Eng-Mohamed-Alaa/Mastering_Embedded_System_Diploma/README.md

# Mastering_Embedded_System_Diploma
### Mohamed Alaa
