Eng-Mohamed-Alaa/Mastering_Embedded_System_Diploma/Projects/Simple_Pressure_Detection/High_Presssure_Detection_Report.pdf

Mastering Embedded System Online Diploma

### https://www.learn-in-depth.com

## First Term (Final Project 1): High Pressure Detection

## Eng. Mohamed Alaa Al-Din Ibrahim Mohamed

My Profile: < learn-in-depth/online-diploma/mohamed.alaa.work.1@gmail.com> (https://www.learn-in-depth.com/online-diploma/mohamed.alaa.work.1%40gmail.com)

Project Link: <github/Mastering_Embedded_System_Diploma/first_term_project1> (https://github.com/Eng-Mohamed-Alaa/Mastering_Embedded_System_Diploma/tree/main/first_term_project1)

CONTENTS

6.5. Design simulation by TTool | Error! Bookmark not defined.

### 1. CASE STUDY

- Description:
- If the pressure exceeds 20 bars in the cabin the system detects high pressure
- When high pressure is detected, the system informs the crew with an alarm (LED)
- The alarm duration is 60 seconds
- In case of high pressure, the next value of pressure is measured after 20 seconds from the moment that alarm is off (quick check)
- In case of normal pressure, the next value of pressure is measured after 100 seconds (normal check)
- Assumptions:
- System setup, reset, and shutdown are not modeled
- The system maintenance is not modeled
- The controller power is never cut
- The pressure sensor never fails
- The alarm never fails

### 2. REQUIREMENT DIAGRAM

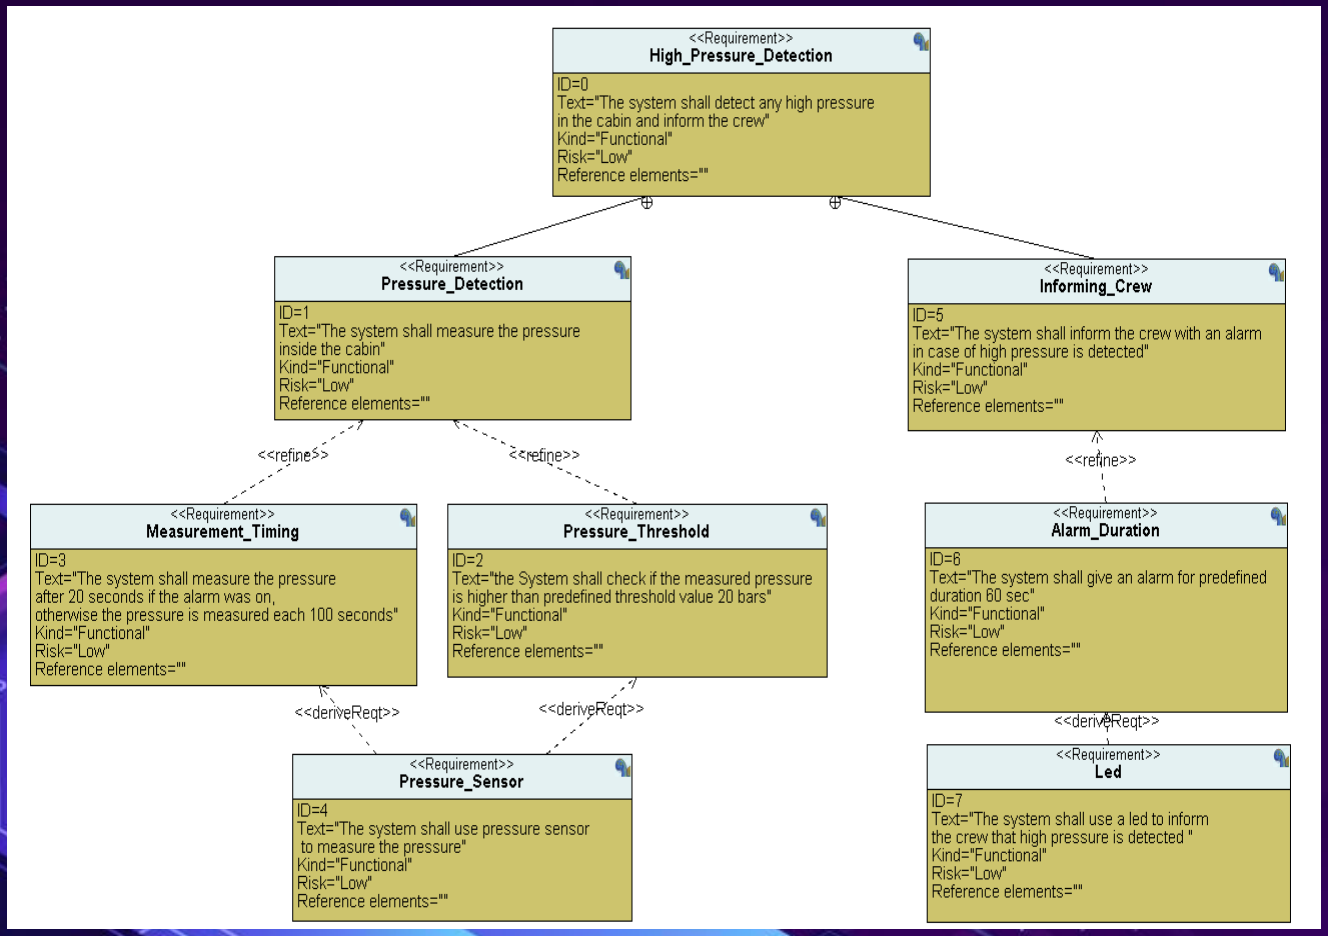
[picture p1: figure]

### 3. USE CASE DIAGRAM

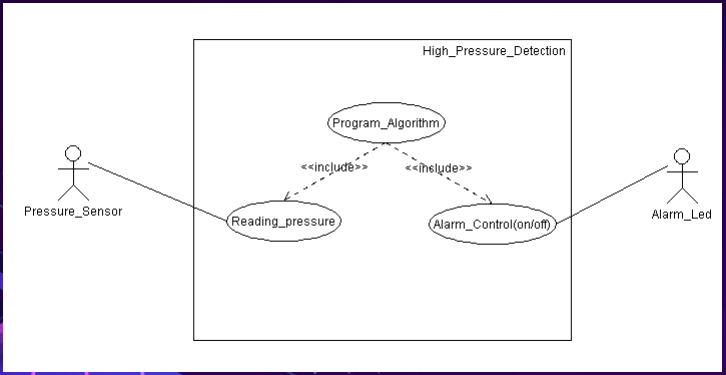
[picture p2: figure]

### 4. ACTIVITY DIAGRAM

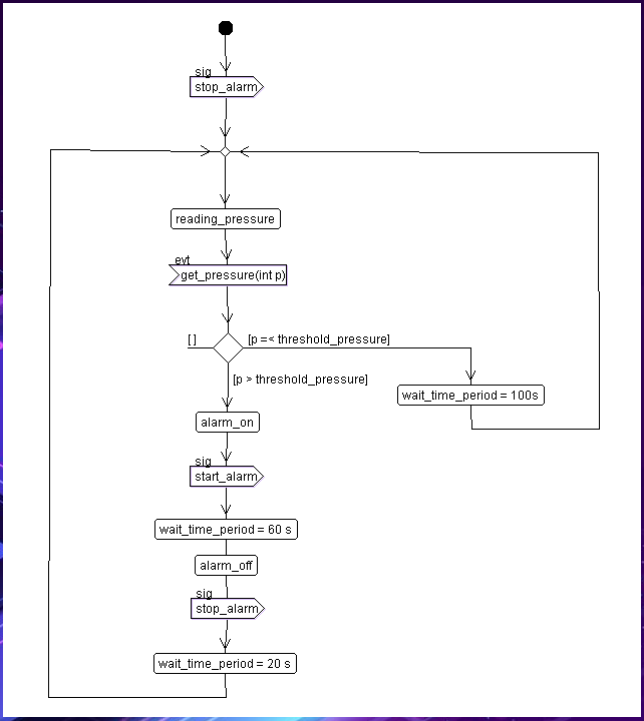
[picture p3: figure]

### 5. SEQUENCE DIAGRAM

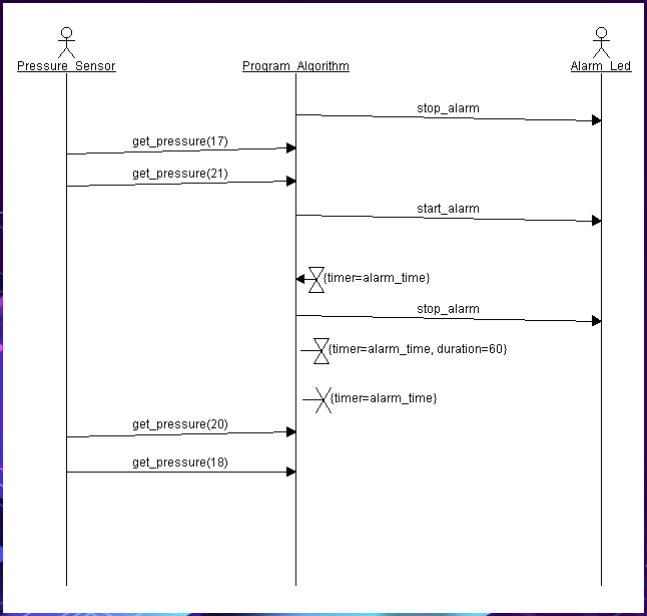
[picture p4: figure]

### 6. DESIGN DIAGRAM

### 6.1. Block diagram

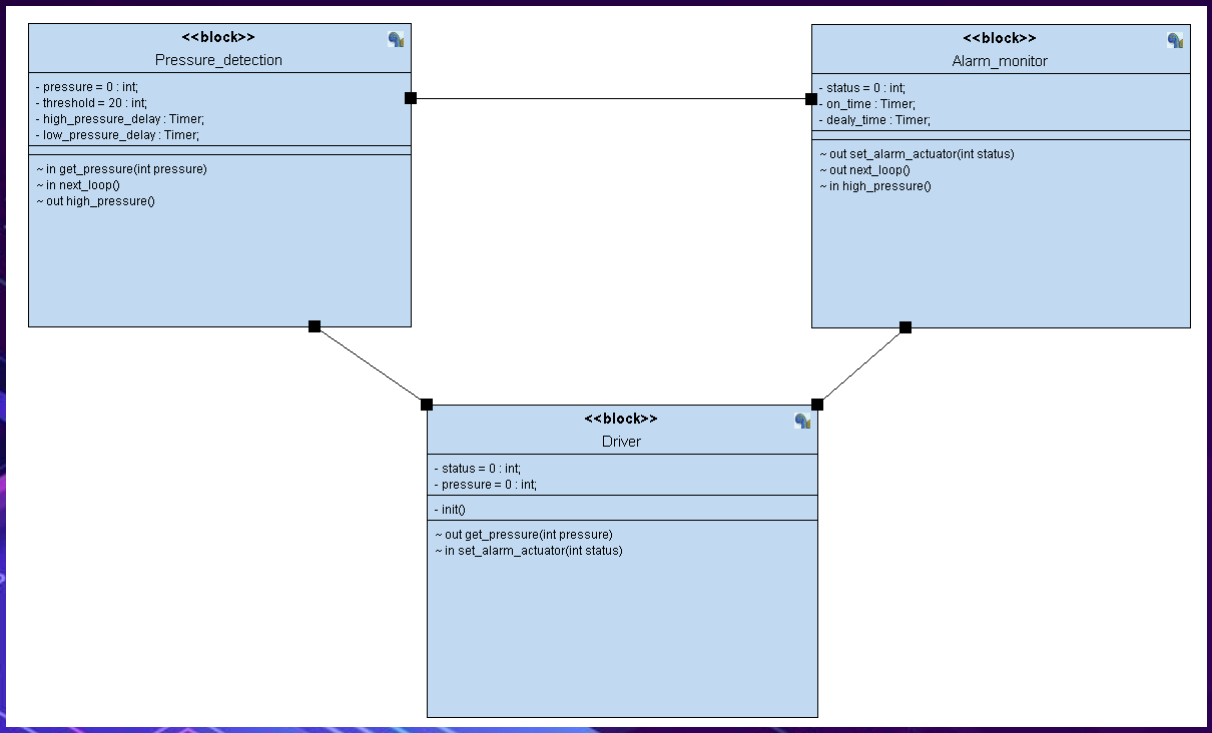
[picture p5: figure]

### 6.2. Pressure detection state machine diagram

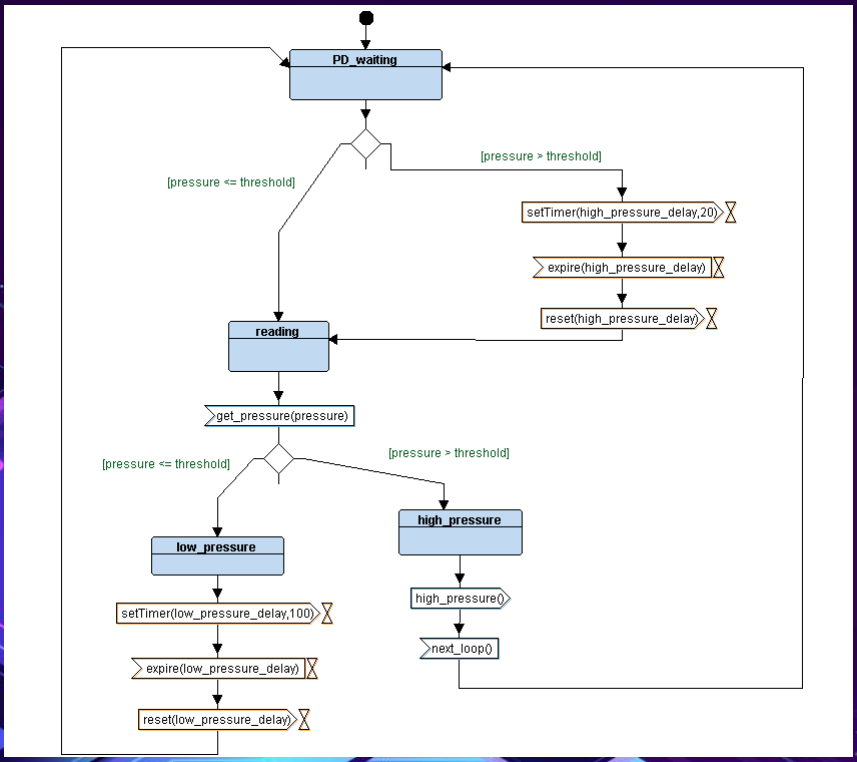
[picture p6: figure]

### 6.3. Alarm monitor state machine diagram

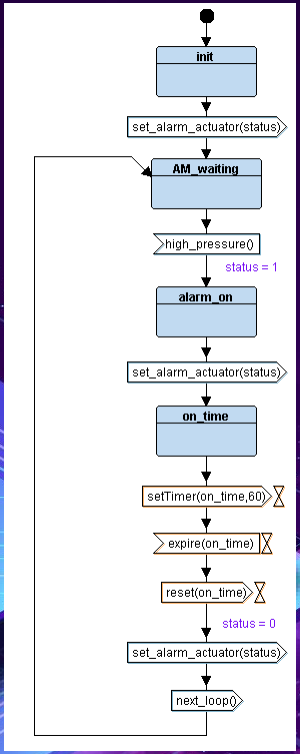
[picture p7: figure]

### 6.4. Driver state machine diagram

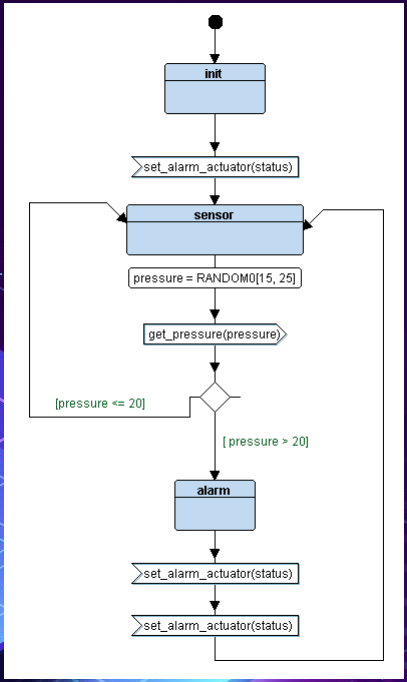
[picture p8: figure]

### 7. SYSTEM SIMULATION BY PROTEUS

### 7.1. Alarm on

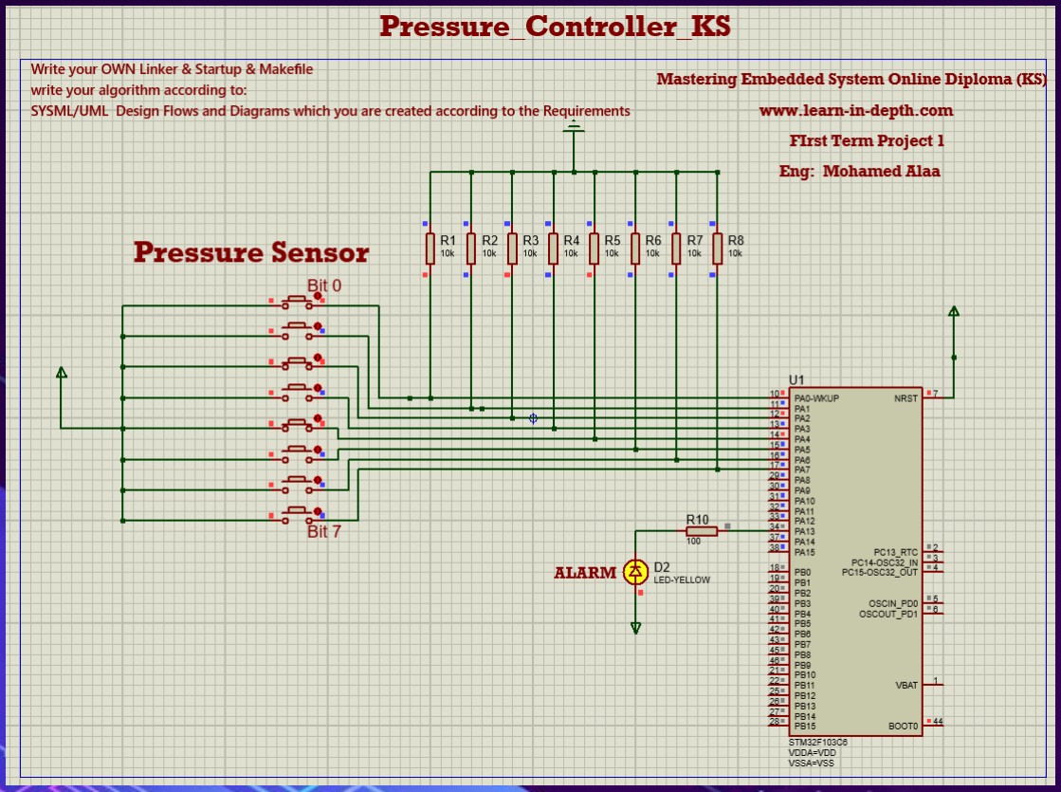
[picture p9: figure]

Pressure = 21 bar

### 7.2. Alarm off

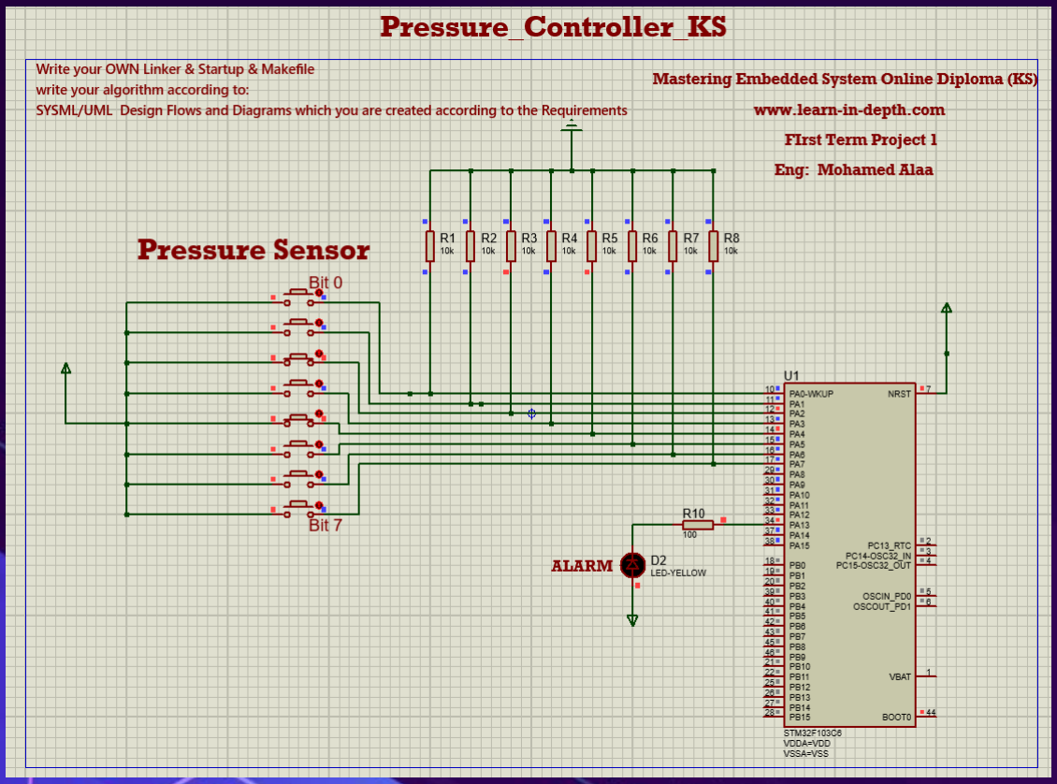
[picture p10: figure]

Pressure = 20 bar

### 8. SW ANALYSIS

### 8.1. Map file

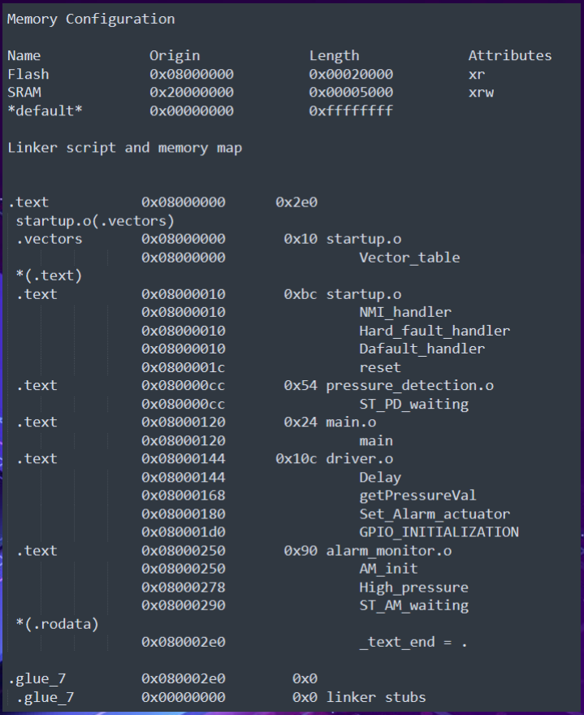
[picture p11: figure]

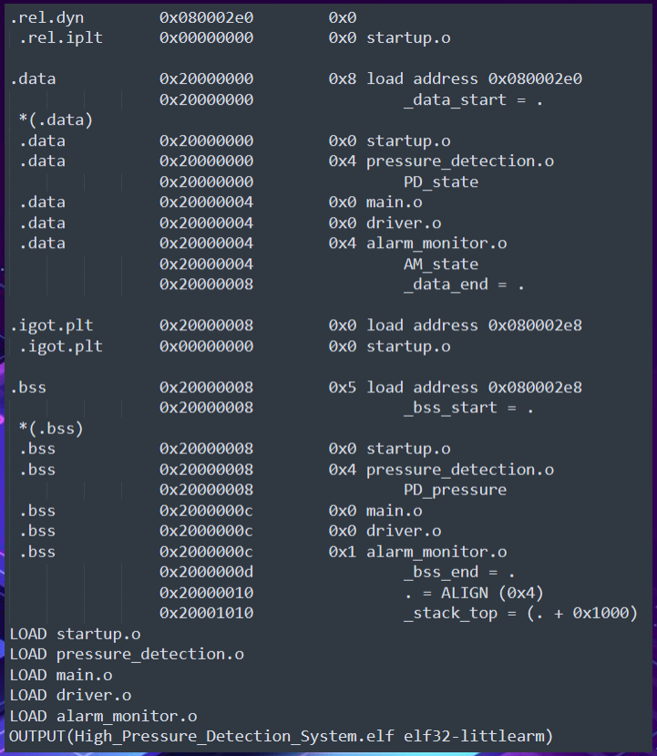
[picture p12: figure]

### 8.2. Section header

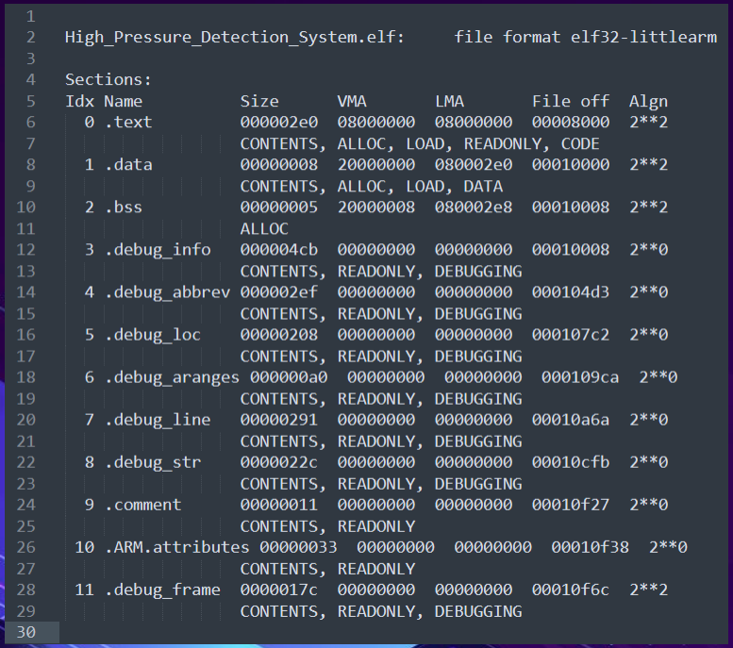
[picture p13: figure]

### 8.3. Symbol table

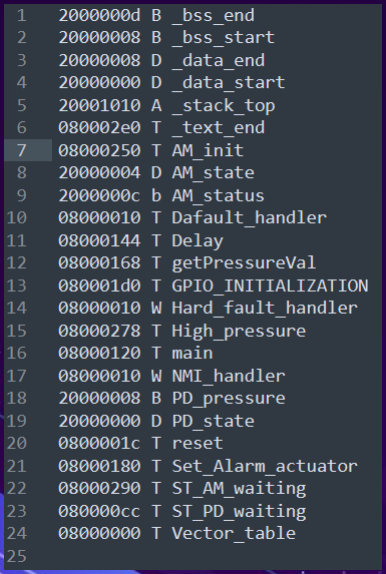
[picture p14: figure]
