Eng-Mohamed-Alaa/Mastering_Embedded_System_Diploma/Unit_4_ System_Architect/lesson_2/Report_Collision_Avoidance_Lab.pdf

# Mastering Embedded System Diploma

## Report name: Collision Avoidance Lab

(Unit 4, Lesson 2)

Submitted by: Eng. Mohamed Alaa

Content

1) Case study
2) Requirement diagram
3) Use case diagram
4) Activity diagram
5) Sequence diagram
6) Design diagram

6..1. Block diagram

6..2. Ultrasonic sensor state machine diagram

6..3. Collison avoidance state machine diagram

6..4. DC motor state machine diagram

7) Running the Program

1) Case study
1) Description:
- The car avoids collision, if the distance between the car and the object is greater than 50 cm the car moves with a constant speed of 30 km/h otherwise the car stops
- Distance is measured by the ultrasonic sensor
- Car moves with DC motor
2) Assumptions:
- System setup and shutdown is not modeled
- The system maintenance is not modeled
- The controller power is never cut
- The ultrasonic sensor never fails
- The DC motor never fails
- The distance is measured continuously without a time delay (time delay is code execution time)

2) Requirement diagram

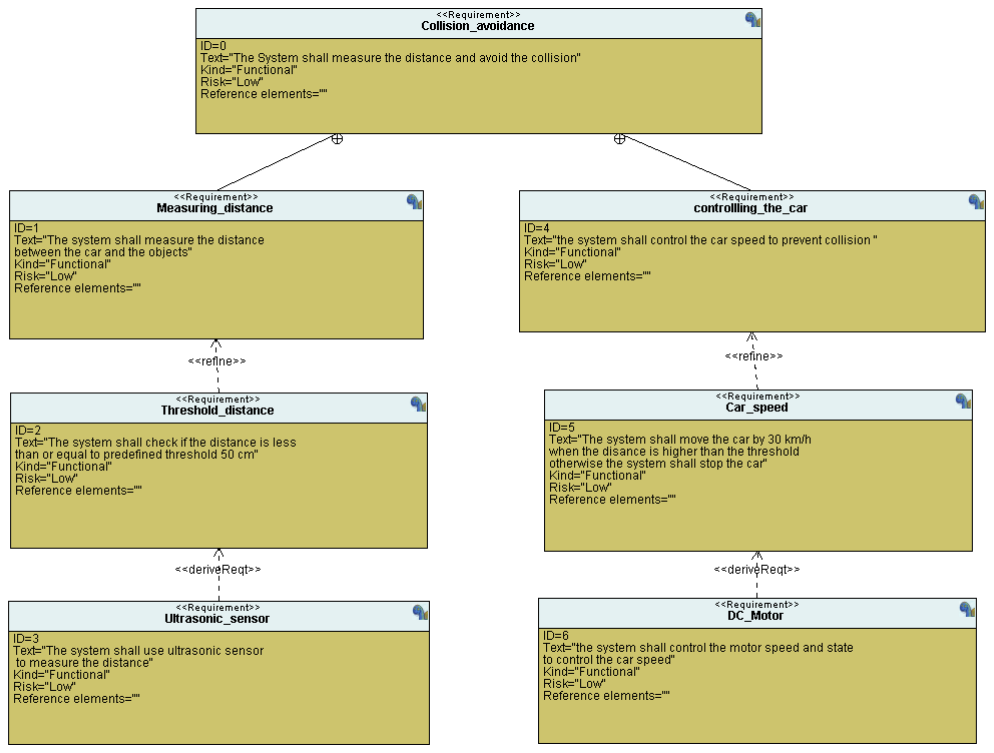
[picture p15: figure]

3) Use case diagram

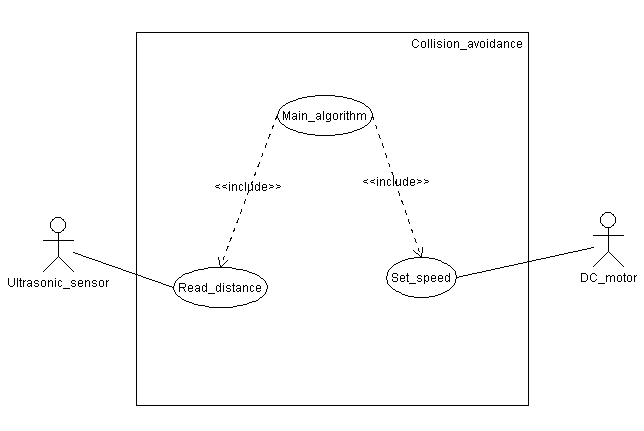
[picture p16: figure]

4) Activity diagram

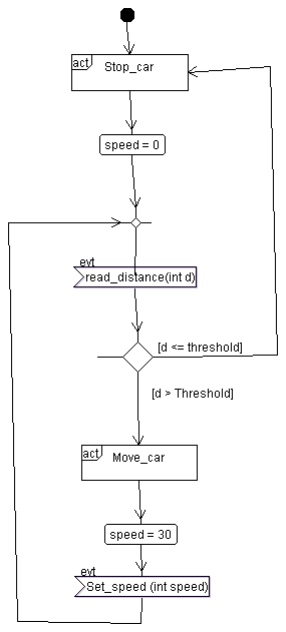
[picture p17: figure]

5) Sequence diagram

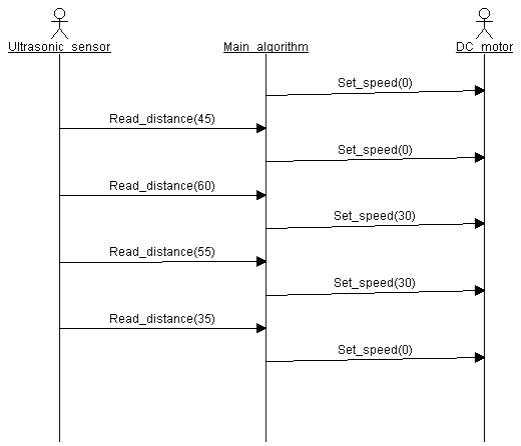
[picture p18: figure]

6) Design diagram

### 6.1. Block diagram

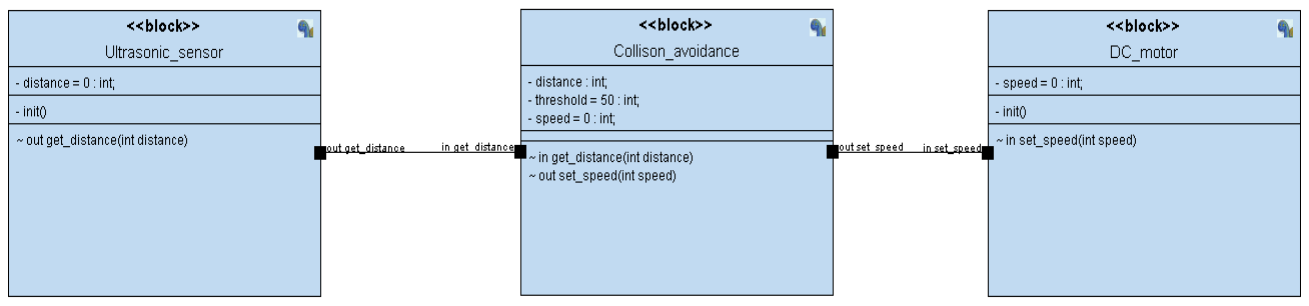
[picture p19: figure]

### 6.2. Ultrasonic sensor state machine diagram

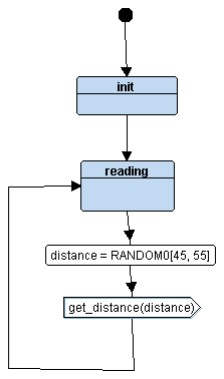
[picture p20: figure]

### 6.3. Collision avoidance state machine diagram

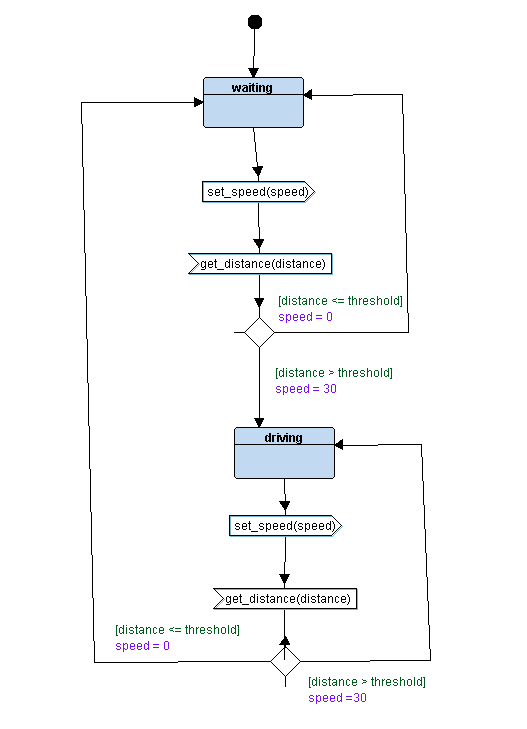
[picture p21: figure]

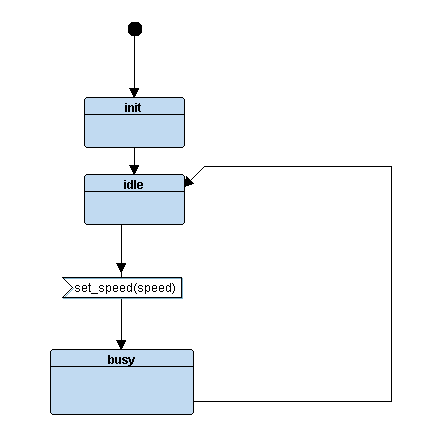
[picture p22: figure]

### 6.4. DC motor state machine diagram

7) Running the Program

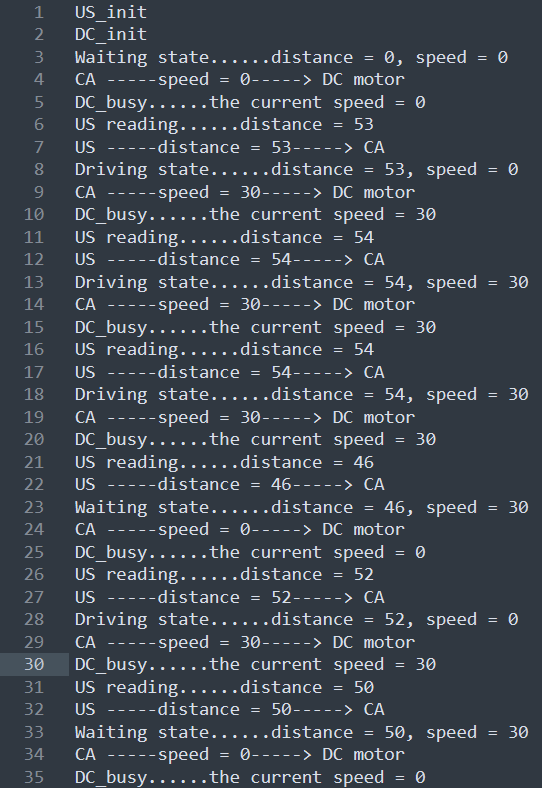
[picture p23: figure]
