Eng-Mohamed-Alaa/Mastering_Embedded_System_Diploma/Projects/Students_Management_System/Students_Management_System_Report.pdf

## Mastering Embedded System Online Diploma

### https://www.learn-in-depth.com

## First Term (Final Project 2)

## Eng. Mohamed Alaa Al-Din Ibrahim Mohamed

My Profile: <learn-in-depth.com/online-diploma/mohamed.alaa.work.1@gmail.com>

Project Link: <github/Mastering_Embedded_System_Diploma/first_term_project2> (https://github.com/Eng-Mohamed-Alaa/Mastering_Embedded_System_Diploma/tree/main/first_term_project2)

CONTENTS

OPTIONS MENU

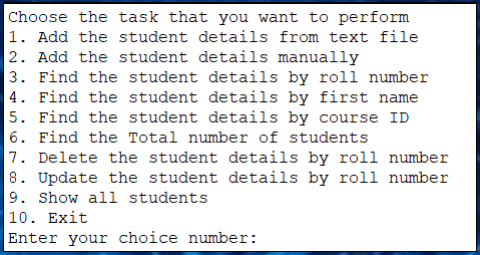
[picture p24: figure]

STUDENT_ADD_FILE()

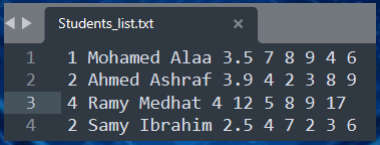
[picture p25: figure]
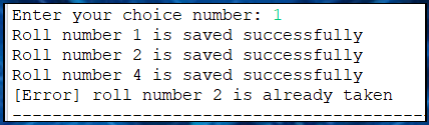
[picture p26: figure]
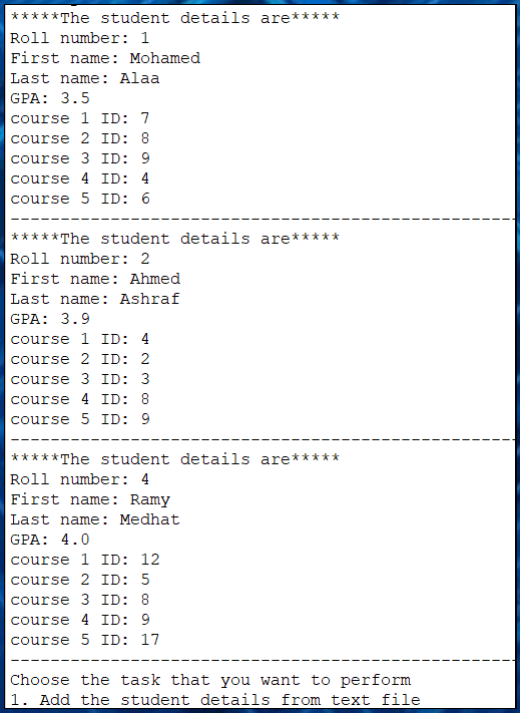
[picture p27: figure]
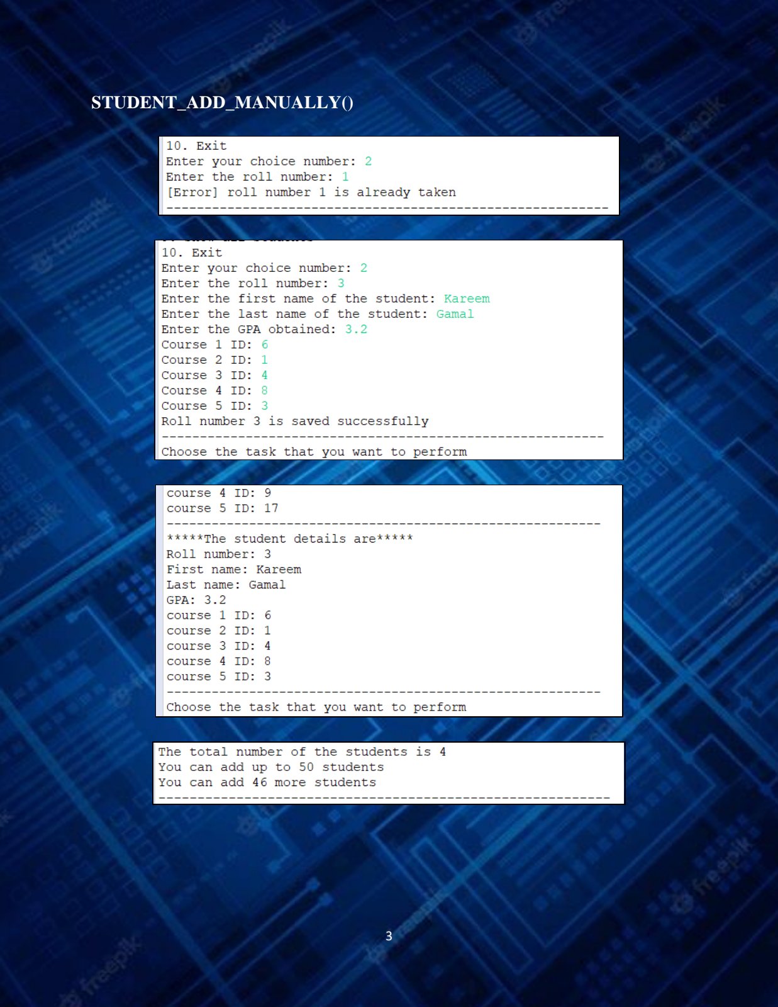
[picture p28: page 5]

STUDENT_ADD_MANUALLY()

STUDENT_FIND_BY_ROLL()

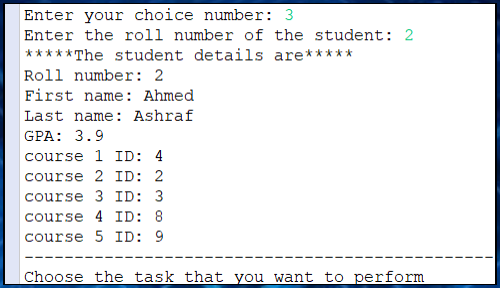
[picture p29: figure]

STUDENT_FIND_BY_FN()

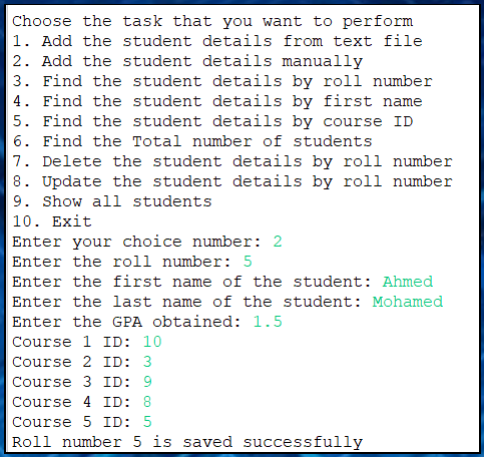
[picture p30: figure]
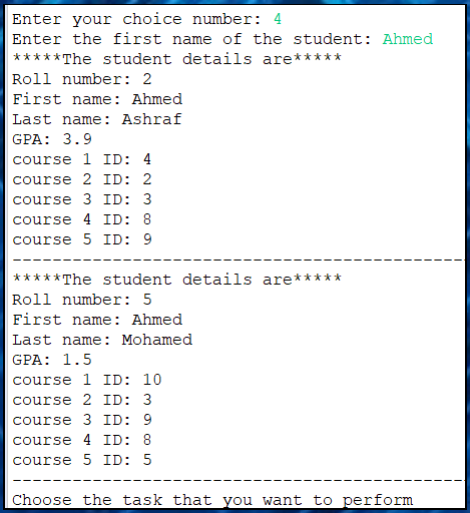
[picture p31: figure]

STUDENT_FIND_BY_COURSE()

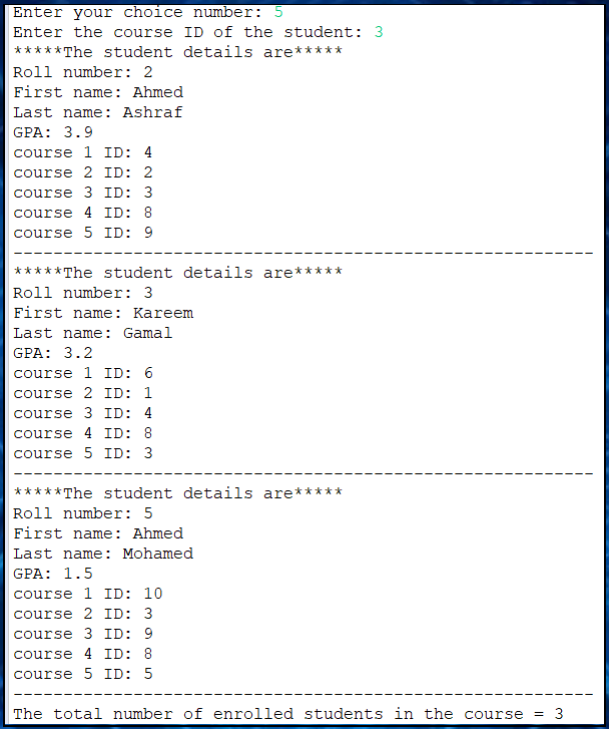
[picture p32: figure]

STUDENT_TOTAL()

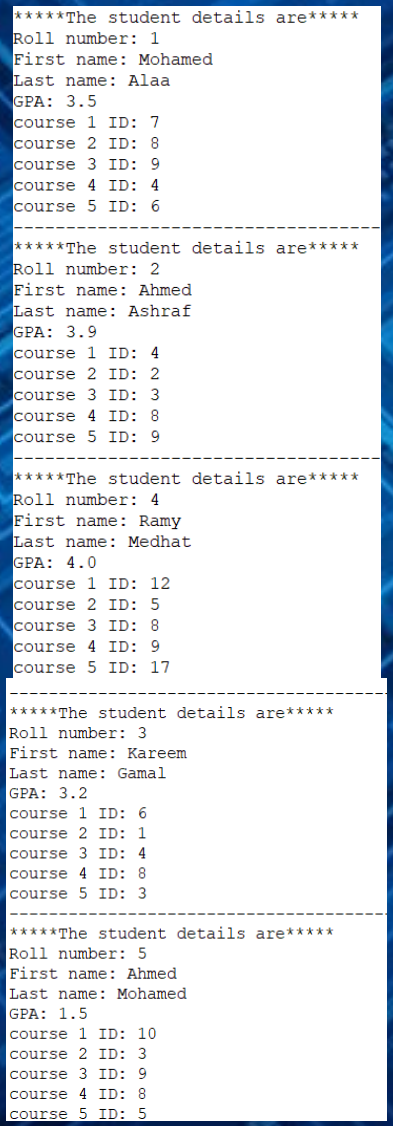
[picture p33: figure]

STUDENT_DELETE()

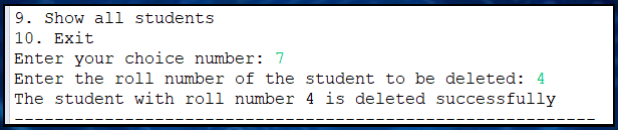
[picture p34: figure]
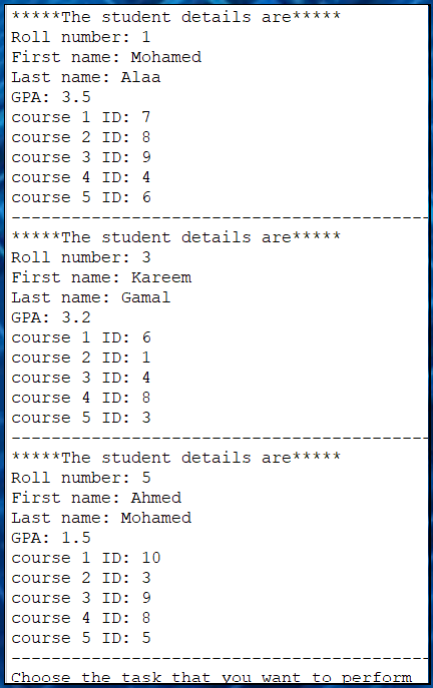
[picture p35: figure]

STUDENT_UPDATE()

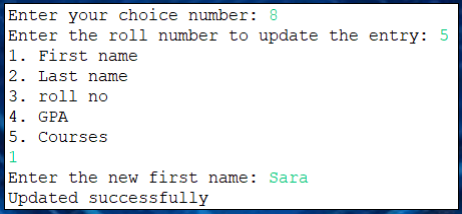
[picture p36: figure]
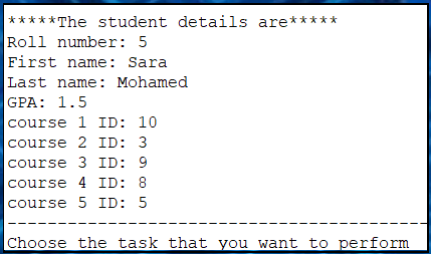
[picture p37: figure]

STUDENT_SHOW_ALL()

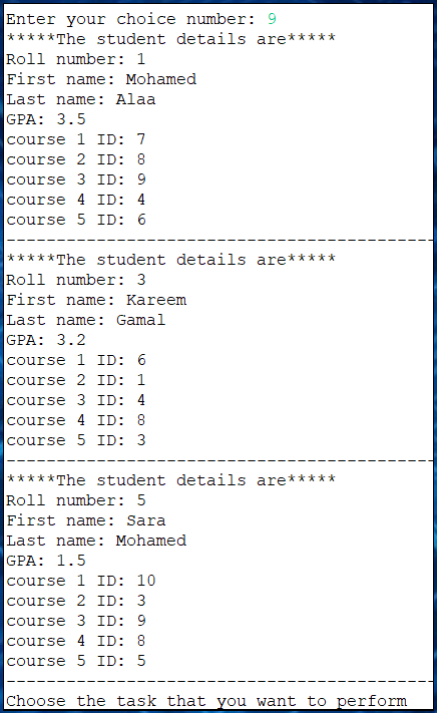
[picture p38: figure]
