Eng-Mohamed-Alaa/Mastering_Embedded_System_Diploma/Projects/Automotive_Diagnostic_Tool_OBD/Diagnostic Tool_State_Machine.png

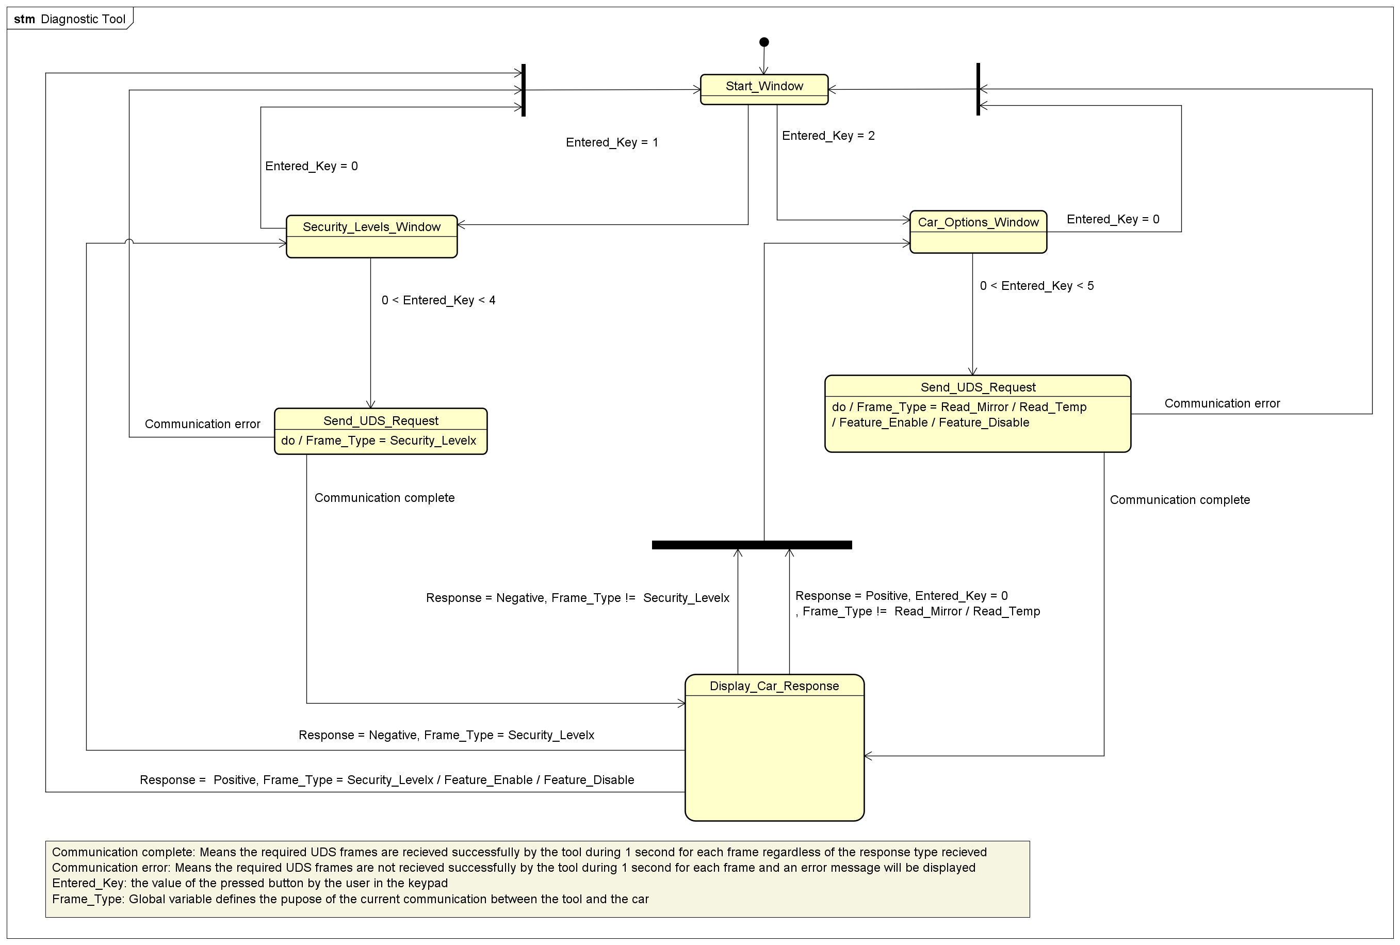
Projects/Automotive_Diagnostic_Tool_OBD/Diagnostic Tool_State_Machine.png
