Eng-Mohamed-Alaa/Mastering_Embedded_System_Diploma/Projects/Automotive_Diagnostic_Tool_OBD/Diagnostic_Tool_Activity_Diagram.png

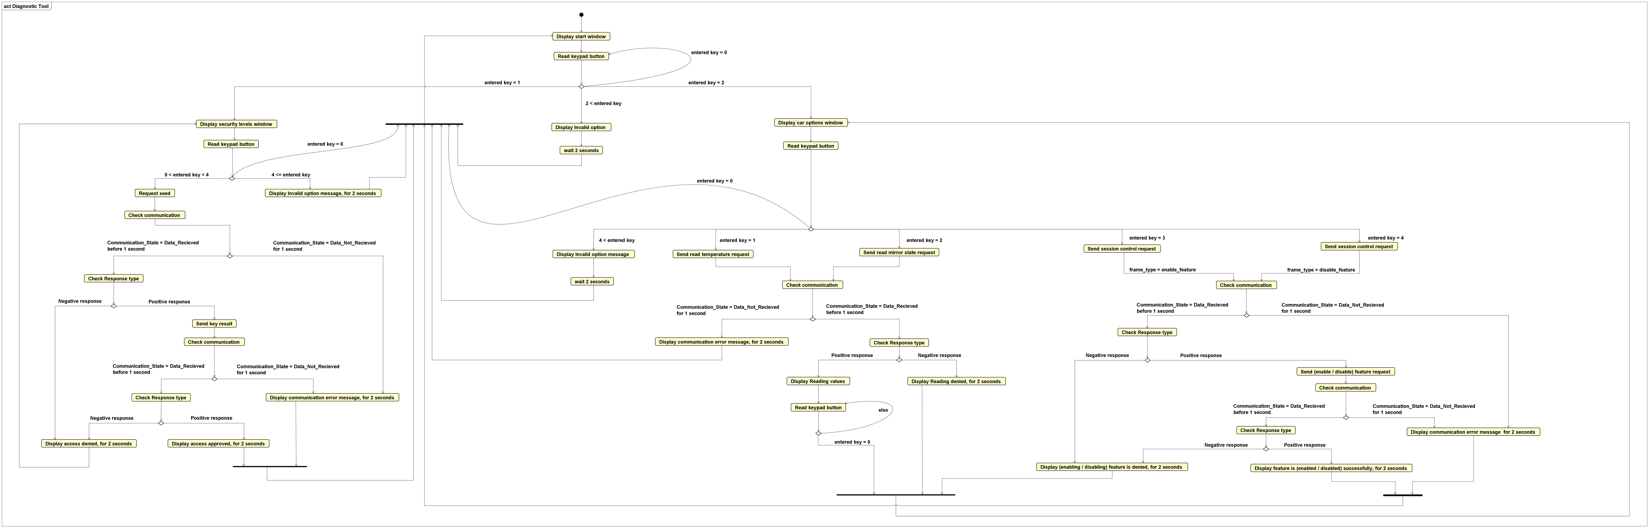
Projects/Automotive_Diagnostic_Tool_OBD/Diagnostic_Tool_Activity_Diagram.png
