Eng-Mohamed-Alaa/Mastering_Embedded_System_Diploma/(list of files, drawings)

Other design files:
Projects/Automotive_Diagnostic_Tool_OBD/Car_ECU/Simulation_Proteus/New Project.pdsprj
Projects/Simple_Pressure_Detection/Hardware_Simulation/yarb.pdsprj
Projects/Smart_Home_FreeRTOS/Simulation/FreeRTOS_Smart_Home.pdsprj
Unit_6_MCU_fundamentals/Lesson_4/Assignment/simulation/New Project.pdsprj
Unit_7_essential_peripherals/lesson_1/Assignment/hardware/AMITKIT.pdsprj
Unit_7_essential_peripherals/lesson_1/Lab/HW/unit7_lesson1.pdsprj
Unit_7_essential_peripherals/lesson_2/Assignment/hardware/LCD_Keypad_ATMEGA32.pdsprj
Unit_7_essential_peripherals/lesson_3/Assignment/HW/unit7_lesson1.pdsprj
Unit_7_essential_peripherals/lesson_3/Lab/HW/unit7_lesson1.pdsprj
Unit_7_essential_peripherals/lesson_4/Lab/HW/unit7_lesson1.pdsprj
Unit_8_MCU_Communication_Protocols/lesson2_UART/Assignment/Assignment_Simulation/LCD_Keypad_ATMEGA32.pdsprj
Unit_8_MCU_Communication_Protocols/lesson3_UART/Assignment/Simulation/LCD_Keypad_ATMEGA32.pdsprj
Unit_8_MCU_Communication_Protocols/lesson3_UART/Lab/Simulation/unit8_lesson3_uart.pdsprj
Unit_8_MCU_Communication_Protocols/lesson4_SPI/Assignment_SPI_7segment/Simulation/New Project.pdsprj
Unit_8_MCU_Communication_Protocols/lesson4_SPI/Assignment_SPI_Master_Slave/Simulation/SPI between two Atmega.pdsprj
Unit_8_MCU_Communication_Protocols/Lesson5_SPI/Lab/Simulation/unit8_lesson5_SPI_lab1.pdsprj
Unit_8_MCU_Communication_Protocols/Lesson5_SPI/Lab/Simulation/unit8_lesson5_SPI_lab2.pdsprj
Unit_8_MCU_Communication_Protocols/Lesson6_I2C/Asignment_HW/SPI between two Atmega.pdsprj
Unit_9_MCU_Timers_ADC/lesson1_Timers/Asignment_Simulation/Timers.pdsprj
Unit_9_MCU_Timers_ADC/lesson2_ADC/Asignment_Simulation/ADC.pdsprj
