Eng-Mohamed-Alaa/Mastering_Embedded_System_Diploma/Unit_6_MCU_fundamentals/Lesson_3/software/Src/lab3.c

//By: Eng.Mohamed Alaa (STM32CubeIDE)
//You can only build 1 lab.c at a time in this project
//from resources configuration you can choose the lab to build

#define RCC_Base	 0x40021000
#define GPIOA_Base	 0x40010800
typedef volatile unsigned long  vuint32_t;


#define RCC_CFGR 	*(vuint32_t *) (RCC_Base + 0x04 )
#define RCC_CR	 	*(vuint32_t *) (RCC_Base)
#define RCC_APB2ENR *(vuint32_t *) (RCC_Base + 0x18 )
#define GPIOA_CRH 	*(vuint32_t *) (GPIOA_Base+0x04)
#define GPIOA_ODR 	*(vuint32_t *) (GPIOA_Base+0x0c)

int main(void)
{
	/*Bits 21:18 PLLMUL[3:0]: PLL multiplication factor
	These bits are written by software to define the PLL multiplication factor. They can be written only
	when PLL is disabled.
	0110: PLL input clock x 8*/
	//PLL source is by default equal to HSI/2 (4 MHz)
	RCC_CFGR |= (0b0110)<<18;

	/*Bit 24 PLLON: PLL enable
	Set and cleared by software to enable PLL.
	Cleared by hardware when entering Stop or Standby mode. This bit can not be reset if the
	PLL clock is used as system clock or is selected to become the system clock. Software
	must disable the USB OTG FS clock before clearing this bit.
	0: PLL OFF
	1: PLL ON*/
	RCC_CR |= 1<<24;

	/*Bits 1:0 SW[1:0]: System clock Switch
	Set and cleared by software to select SYSCLK source.
	Set by hardware to force HSI selection when leaving Stop and Standby mode or in case of failure of
	the HSE oscillator used directly or indirectly as system clock (if the Clock Security System is
	enabled).
	00: HSI selected as system clock
	01: HSE selected as system clock
	10: PLL selected as system clock
	11: Not allowed*/
	RCC_CFGR |= 1<<1;

	/*Bits 10:8 PPRE1[2:0]: APB Low-speed prescaler (APB1)
	Set and cleared by software to control the division factor of the APB Low speed clock (PCLK1).
	100: HCLK divided by 2*/
	RCC_CFGR |= (0b100) << 8;

	/*Bits 13:11 PPRE2[2:0]: APB high-speed prescaler (APB2)
	Set and cleared by software to control the division factor of the APB High speed clock (PCLK2).
	101: HCLK divided by 4*/
	RCC_CFGR |= (0b101) << 11;

	/*Bit 2 IOPAEN: I/O port A clock enable
	Set and cleared by software.
	0: I/O port A clock disabled
	1:I/O port A clock enabled*/
	RCC_APB2ENR |= 1<<2;
	GPIOA_CRH &= 0xff0fffff;
	GPIOA_CRH |= 0x00200000;
	while(1)
	{
		GPIOA_ODR |= 1<<13;
		for(int i=0; i < 5000; ++i){}
		GPIOA_ODR &= ~(1<<13);
		for(int i=0; i < 5000; ++i){}
	}
	return 0;
}
