Eng-Mohamed-Alaa/Mastering_Embedded_System_Diploma/Projects/Smart_Home_FreeRTOS/Code/AVR_ATmega32_Drivers/HAL/LM35_Sensor/LM35_Includes/lm35_Cfg.h

#ifndef LM35_CFG_H
#define LM35_CFG_H

#include <MCAL/PORT/PORT_Includes/Port.h>
#include <MCAL/ADC/ADC_Includes/ADC.h>

#define SENSOR_CHANNEL			  ADC_Channel_ADC0
#define SENSOR_MAX_VOLT_VALUE     1.5
#define SENSOR_MAX_TEMPERATURE    150
#define ADC_REF_VOLT_VALUE		  5
#define ADC_MAXIMUM_VALUE		  1023


#endif
