Eng-Mohamed-Alaa/Mastering_Embedded_System_Diploma/Projects/Smart_Home_FreeRTOS/Code/AVR_ATmega32_Drivers/MCAL/PORT/PORT_Includes/Port_Private.h

/*
 * Port_Private.h
 *
 * Created: 10/20/2023 12:11:10 PM
 *  Author: computer store
 */ 

#ifndef PORT_PRIVATE_H_
#define PORT_PRIVATE_H_

// this file is empty but may be used for the future features



#endif /* PORT_PRIVATE_H_ */
