Eng-Mohamed-Alaa/Mastering_Embedded_System_Diploma/Unit_8_MCU_Communication_Protocols/lesson7_I2C/Lab_SW/HAL/Inc/I2C_Slave_EEPROM.h

#ifndef INC_I2C_SLAVE_EEPROM_H_
#define INC_I2C_SLAVE_EEPROM_H_

//--------------------------------------------------------
//includes
//--------------------------------------------------------

#include <stdint.h>
#include <STM32F103C6_I2C_Driver.h>

//--------------------------------------------------------
//configuration macros
//--------------------------------------------------------

#define EEPROM_Slave_Address	0x2A

//--------------------------------------------------------
//EEPROM APIs
//--------------------------------------------------------

void EEPROM_Init(void);
uint8_t	EEPROM_Write_Nbytes(uint16_t Memory_Address, uint8_t* Data, uint8_t Data_Length);
uint8_t	EEPROM_Read_Nbytes(uint16_t Memory_Address, uint8_t* Data, uint8_t Data_Length);


#endif /* INC_I2C_SLAVE_EEPROM_H_ */
