Eng-Mohamed-Alaa/Mastering_Embedded_System_Diploma/Projects/Automotive_Diagnostic_Tool_OBD/Car_ECU/Inc/HAL/Servo_Motor/Servo_Motor.h

/*
 * Servo_Motor.h
 *
 *  Created on: Nov 26, 2023
 *      Author: computer store
 */

#ifndef HAL_SERVO_MOTOR_SERVO_MOTOR_H_
#define HAL_SERVO_MOTOR_SERVO_MOTOR_H_

#include "../SERVICES/Standard_Data_Types.h"

void Servo_Init(void);
void Servo_Rotate(uint16 Rotation_Angle);
void Servo_Stop(void);


#endif /* HAL_SERVO_MOTOR_SERVO_MOTOR_H_ */
