Eng-Mohamed-Alaa/Mastering_Embedded_System_Diploma/Projects/Automotive_Diagnostic_Tool_OBD/Car_ECU/Inc/HAL/LED/LED.h

/*
 * LED.h
 *
 *  Created on: Dec 6, 2023
 *      Author: computer store
 */
#ifndef HAL_LED_LED_H_
#define HAL_LED_LED_H_

void LED_Init(void);
void LED_DeInit(void);
void LED_On(void);
void LED_OFF(void);

#endif /* HAL_LED_LED_H_ */
