Eng-Mohamed-Alaa/Mastering_Embedded_System_Diploma/Projects/Automotive_Diagnostic_Tool_OBD/Car_ECU/Inc/HAL/LED/LED_CFG.h

/*
 * LED_CFG.h
 *
 *  Created on: Dec 6, 2023
 *      Author: computer store
 */

#ifndef HAL_LED_LED_CFG_H_
#define HAL_LED_LED_CFG_H_

#include "MCAL/GPIO/GPIO.h"

#define LED_PORT				GPIO_PORT_C
#define LED_PIN					GPIO_PIN_13
#define LED_Mode				output_Open_drain
#define LED_Max_Speed			GPIO_max_speed_2_MHz


#endif /* HAL_LED_LED_CFG_H_ */
