Eng-Mohamed-Alaa/Mastering_Embedded_System_Diploma/Projects/Automotive_Diagnostic_Tool_OBD/Car_ECU/Inc/MCAL/I2C/I2C_PRIV.h

/**
 ******************************************************************************
 * @file           : I2C_PRIV.h
 * @Author:        : Ahmed Radwan
 * @Created on:    : Nov 25, 2023
 ******************************************************************************
 */

#ifndef MCAL_I2C_I2C_PRIV_H_
#define MCAL_I2C_I2C_PRIV_H_



/************************************* include section ****************************************/


/************************************* include section end ************************************/

/***************************************** macros section *************************************/
#define I2C_BASE_ADREES 0x40005400



/*********************************** macros section end ***************************************/


/*********************************** user defined data types section **************************/


/*********************************** user defined data types section end **************************/



/****************************** function prototypes section****************************************/


/****************************** function prototypes section end************************************/

#endif /* MCAL_I2C_I2C_PRIV_H_ */
