Eng-Mohamed-Alaa/Mastering_Embedded_System_Diploma/Projects/Automotive_Diagnostic_Tool_OBD/Car_ECU/Inc/MCAL/RCC/RCC_CFG.h

/**
 ******************************************************************************
 * @file           : RCC_CFG.h
 * @Author:        : Ahmed Radwan
 * @Created on:    : Nov 15, 2023
 ******************************************************************************
 */

#ifndef MCAL_RCC_RCC_CFG_H_
#define MCAL_RCC_RCC_CFG_H_



/************************************* include section ****************************************/


/************************************* include section end ************************************/

/***************************************** macros section *************************************/

// define this with the exyernal clock source frequancy
#define EXTERNAL_FREQ 8000000

/*********************************** macros section end ***************************************/


/*********************************** user defined data types section **************************/


/*********************************** user defined data types section end **************************/



/****************************** function prototypes section****************************************/


/****************************** function prototypes section end************************************/

#endif /* MCAL_RCC_RCC_CFG_H_ */
