Eng-Mohamed-Alaa/Mastering_Embedded_System_Diploma/Projects/Automotive_Diagnostic_Tool_OBD/Car_ECU/Src/MCAL/CAN/CAN_config.c

/**************************************************************************/
/* Filename						: CAN_config.c                            */
/* Author  	    				: Muhammad Ammar                          */
/* Date 						: Nov 15, 2023  	           	 	         	 */ 
/* Version 	 					: V01                                     */
/* MicroController  			: STM32429 								   */
/**************************************************************************/





/********************************** Includes *********************************************/


/********************************** Private declaration **********************************/



/********************************** Data Type Declarations ****************************/


/********************************** Macros Declarations *******************************/

/********************************** Macros Function Declarations *********************/




/******************************* Software Interfaces Implementation *******************/



/**************************** Private Software Interface Implementation **************/
