Eng-Mohamed-Alaa/Mastering_Embedded_System_Diploma/Projects/Automotive_Diagnostic_Tool_OBD/DIAGNOSTIC_TOOL/Src/screens.h

void SCREEN_securityLevel1POS(uint8 Copy_u8level);

void SCREEN_securityLevel1NEG(uint8 Copy_u8level);

void SCREEN_Temp(uint8 Copy_u8DTC, uint8 Copy_u8CurrentReading);
void SCREEN_Mirror(uint8 Copy_u8DTC, uint8 Copy_u8CurrentReading);


extern Usart_ConfigType Usart1 ;
#define UART_GUI			ONE_VALUE
