Eng-Mohamed-Alaa/Mastering_Embedded_System_Diploma/(commit log)

2023-04-15 Lesson 2 lab (Collision Avoidance)
    [CA.c, CA.h, DC_motor.c, DC_motor.h, main.c, state.h, ultrasonic.c, ultrasonic.h]
2023-06-18 First term Projects
    [yarb.pdsprj]
2023-06-27 unit6 and unit7
    [AMITKIT.pdsprj, LCD_Keypad_ATMEGA32.pdsprj, New Project.pdsprj, unit7_lesson1.pdsprj]
2023-09-09 Unit 8
    [LCD_Keypad_ATMEGA32.pdsprj, New Project.pdsprj, SPI between two Atmega.pdsprj, unit8_lesson3_uart.pdsprj, unit8_lesson5_SPI_lab1.pdsprj, unit8_lesson5_SPI_lab2.pdsprj]
2023-09-09 Unit 9
    [ADC.pdsprj, Timers.pdsprj]
2023-09-29 All drivers
2023-11-16 NTI Smart Home Project using FreeRTOS
    [SPI between two Atmega.pdsprj]
2023-12-24 NTI Graduation Project, UDS over CAN protocol
    [New Project.pdsprj]
2023-12-24 this project focus on system design, make file, linker script and startup code
    [yarb.pdsprj]
2023-12-24 smart home using FreeRTOS on ATmega32
    [FreeRTOS_Smart_Home.pdsprj]
